Thomas2809/transmission/(threads)

Thread 1 (2024-05-30):

Temps de conversion

kpa-inraci, 2024-05-30:
Suite à un souci de vitesse on a réalisé que on passe plus de temps dans l'interruption que dans le main.
Une des solutions, serait de changer la méthode de convertion.
Actuellement nous restons 180ms en interruption. @Daoud1190  & @Thomas2809  nous ne changerons pas la structure si proche de la fin du projet.
