Thomas2809/transmission/(commit log)

2024-04-10 Premier echange de commit
    Kapita a fait le premier commit
2024-04-10 echange de test
    Thomas a modifie
2024-04-11 modification du setup
    Initialisation des ads et bluetooth
2024-04-15 init_ads1_ads2
    init des deux ads
2024-04-22 création_moyenne
    je prends 10 mesures et je fais une moyenne pour envoyer la meilleur.
2024-05-26 modification du tactil
    rotation de 180° et modification du bouton retour
2024-05-26 table des matières
2024-05-26 ajout de la vidéo
2024-05-26 amélioration de la table des matières
2024-05-28 correction des liens de la table des matières
2024-05-28 modification des bibliothèques
2024-05-29 ajout de lien de la reception
2024-06-06 Ajout des datasheets
